4x4falcon/DCC-Turnout-Decoder/README.md

DCC Turnout Decoder for solenoid turnouts

This is deprecated use this firmware instead:

https://github.com/Rosscoetrain/DCC-Turnout-Decoder-2

This repository is no longer updated.  Kept for reference only.
