4x4falcon/DCC-Turnout-Decoder/(list of files, drawings)

Other design files:
hardware/driver_board.fzz
hardware/turnout_decoder_nano.fzz
