4x4falcon/DCC-Turnout-Decoder/CV_list.h

/*
 *   List of control variables used and functions to handle them
 *   // not currently used
 */

void resetDefault()
 {
  
 }

void writeCV2EEPROM(int cv, int value)
 {

 }

int readCVFromEEPROM(int cv)
 {

  return 0;
 }
