4x4falcon/DCC-Turnout-Decoder/(commit log)

2022-09-23 Add driver board
    [driver_board.fzz]
2022-09-29 added docs update fritzing file
    [turnout_decoder_nano.fzz]
